ostojaatanasijevic/noise_gate/README.md

# TPI pedals - BMF

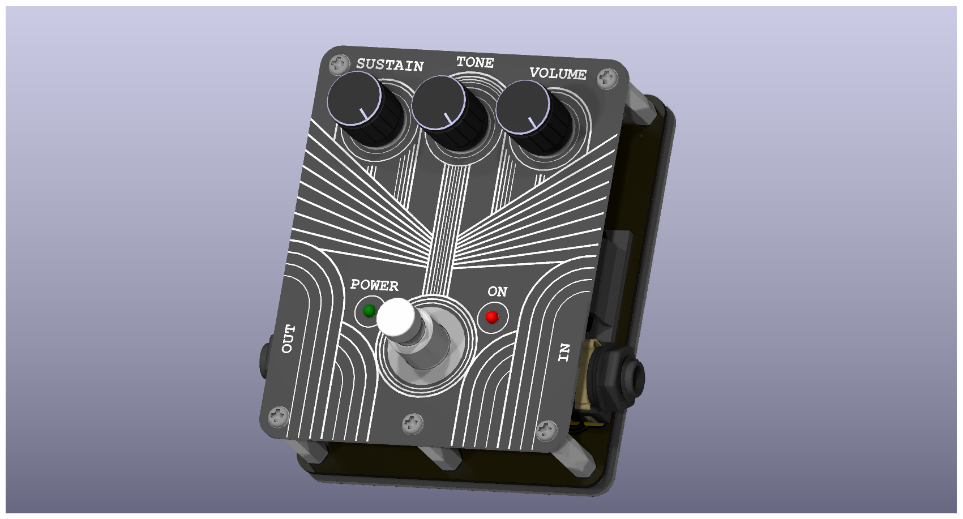
[picture p1: noise_gate/big_muff_pi_side.png]
side_view

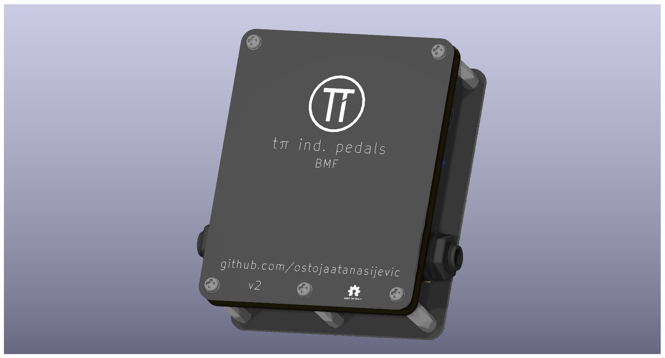
[picture p2: noise_gate/big_muff_pi_bottom.png]
top_view


## Schematic
schematic
