ostojaatanasijevic/noise_gate/noise_gate/big_muff_pi_top.png

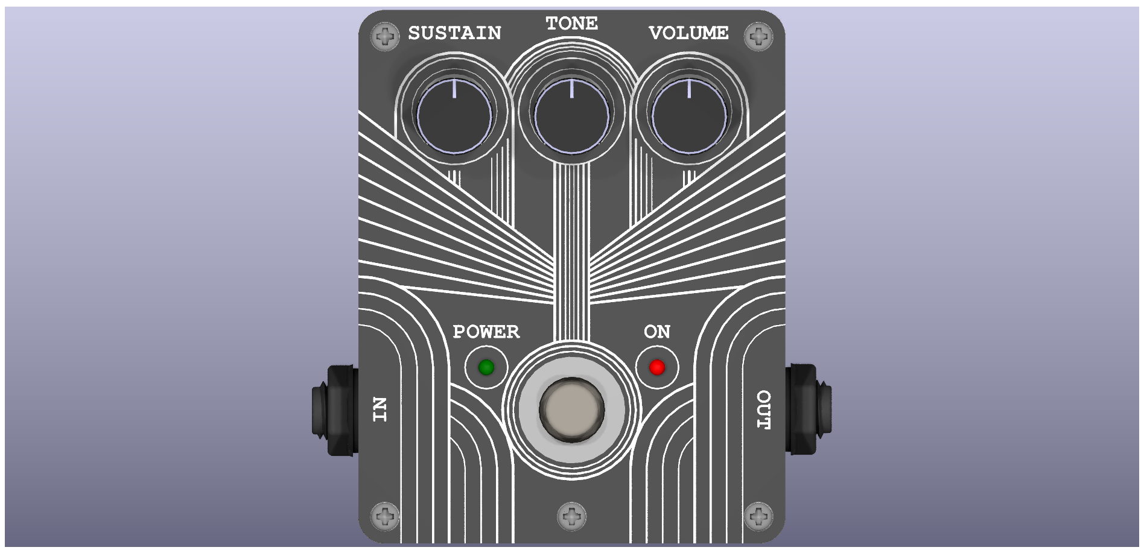
noise_gate/big_muff_pi_top.png
