ostojaatanasijevic/noise_gate/bottom_plate.step

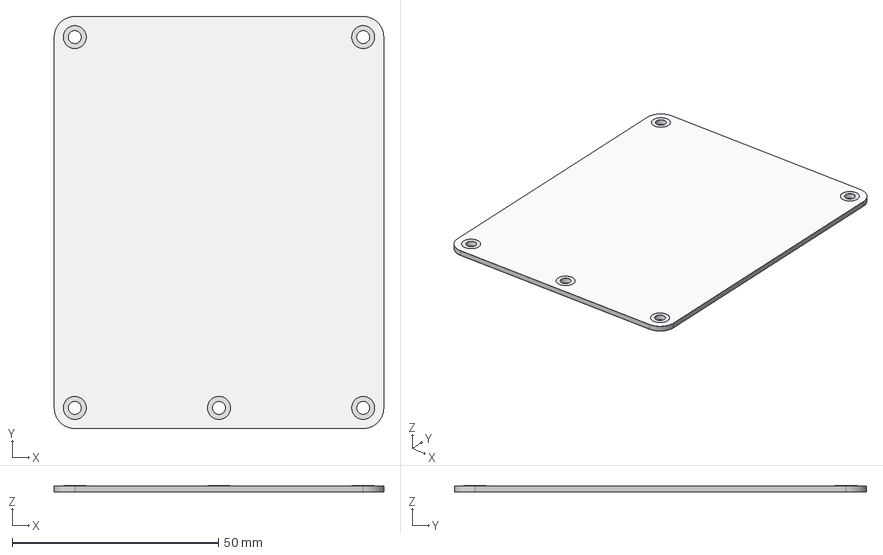
[picture p4: CAD file, 2025-06-01]
bottom_plate.step
80.0 x 100.0 x 1.64 mm
noise_gate_bottom_plate_pad
noise_gate_bottom_plate_silkscreen
noise_gate_bottom_plate_soldermask
noise_gate_bottom_plate_PCB
