ostojaatanasijevic/noise_gate/noise_gate_bottom_plate/3-d-nmj6hhd2.stp

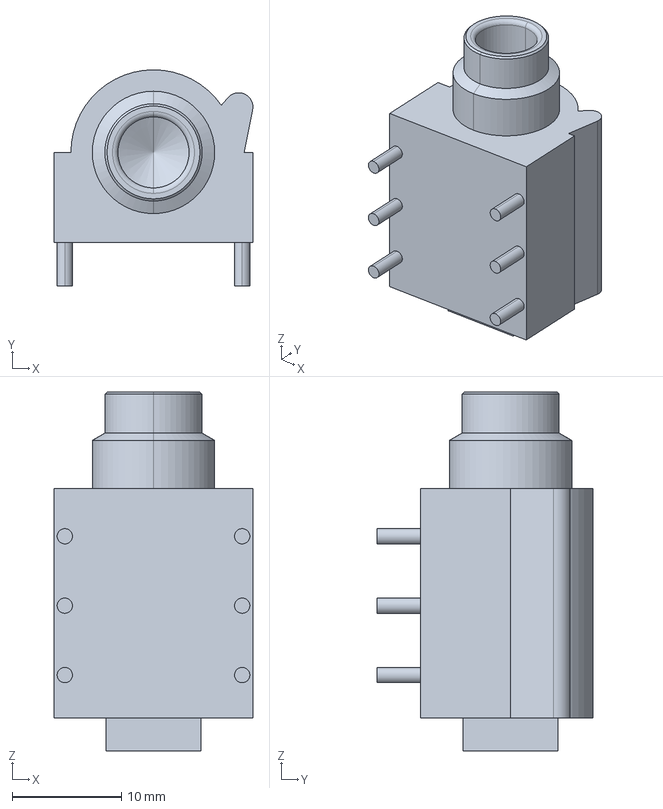
[picture p5: CAD file, 2025-05-28]
noise_gate_bottom_plate/3-d-nmj6hhd2.stp
18.2 x 19.8 x 32.9 mm
