ostojaatanasijevic/noise_gate/noise_gate_bottom_plate/NMJ6HFD2-AU--3DModel-STEP-418109.STEP

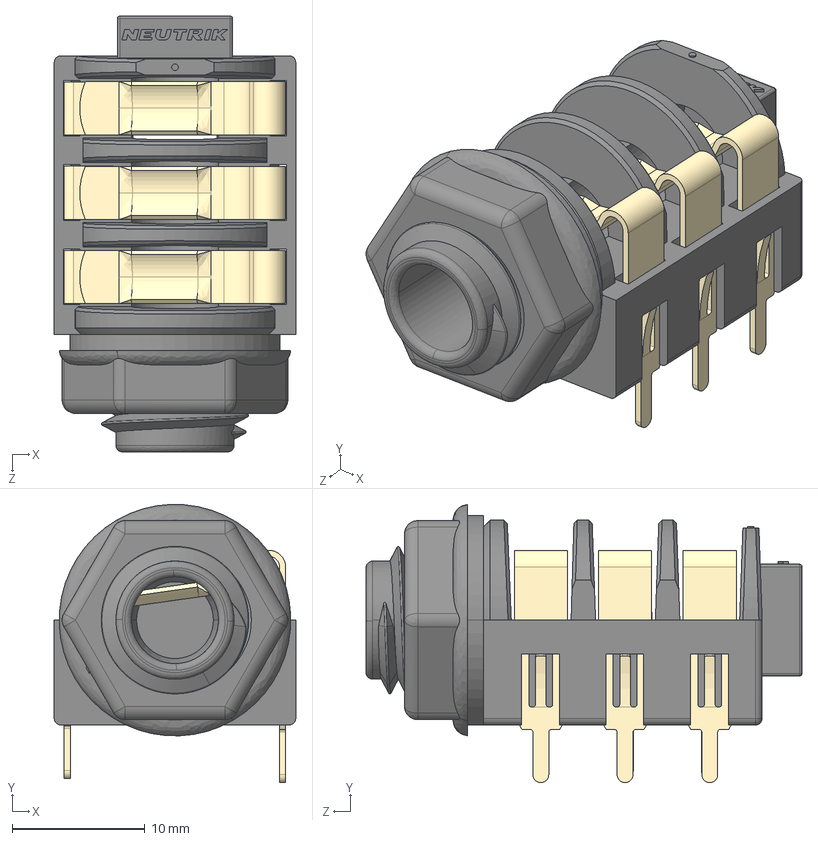
[picture p6: CAD file, 2025-05-28]
noise_gate_bottom_plate/NMJ6HFD2-AU--3DModel-STEP-418109.STEP
18.2 x 21.0 x 32.9 mm
