ostojaatanasijevic/noise_gate/noise_gate_front_plate/switch.STEP

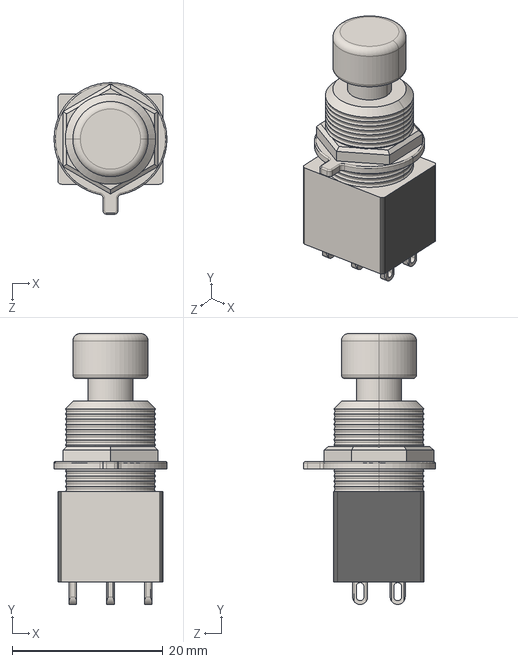
[picture p7: CAD file, 2025-05-28]
noise_gate_front_plate/switch.STEP
15.0 x 36.0 x 17.5 mm
