ostojaatanasijevic/noise_gate/noise_gate_bottom_plate/noise_gate_bottom_plate.step

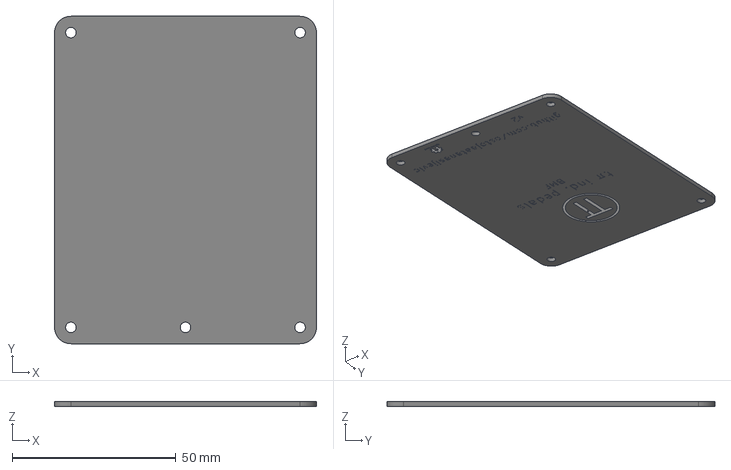
[picture p8: CAD file, 2025-05-28]
noise_gate_bottom_plate/noise_gate_bottom_plate.step
80.0 x 100.0 x 1.58 mm
big_muff_pi_bottom_plate_silkscreen
big_muff_pi_bottom_plate_PCB
