ostojaatanasijevic/noise_gate/noise_gate_front_plate/9V-battery.stp

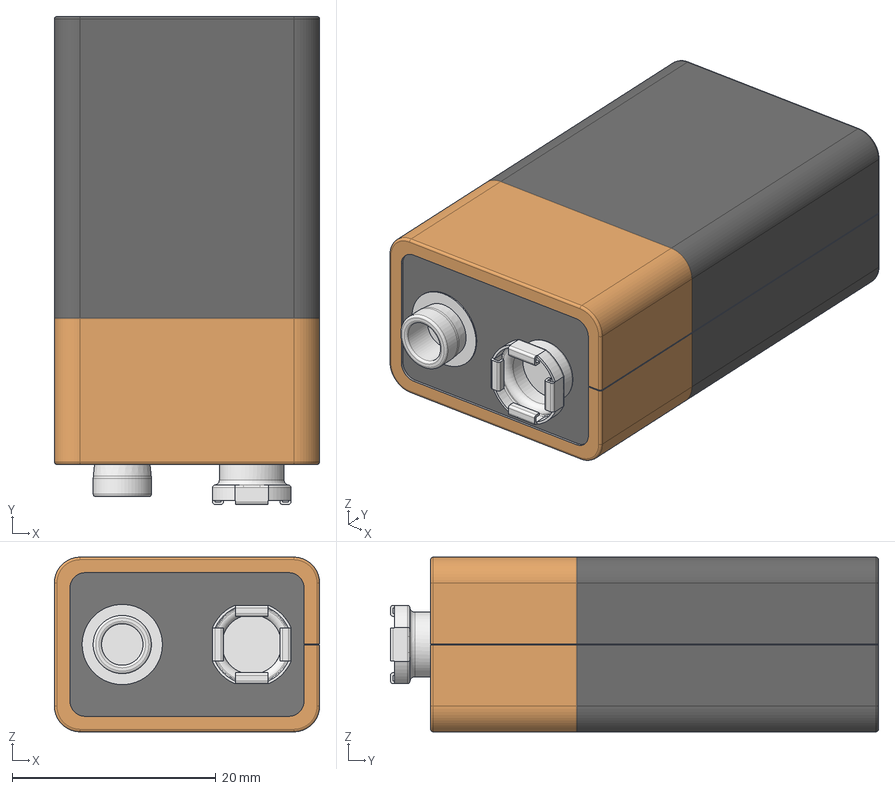
[picture p9: CAD file, 2025-05-28]
noise_gate_front_plate/9V-battery.stp
26.0 x 47.9 x 17.1 mm
