ostojaatanasijevic/noise_gate/noise_gate/input_bjt_stage.asc

C1: cap; 1µ
C2: cap; 470p
Q1: npn; 2N5551
R1: res; 100
R2: res; 47k
R3: res; 4.7k
R4: res; 470k
R5: res; 10k
V1: voltage; SINE(0 20m 1k)
V2: voltage; 9
Named nets: 0
.tran 100m
