ostojaatanasijevic/noise_gate/noise_gate/simulations/Draft1.asc

C1: cap; 1.2µ
C2: cap; 1.2µ
C3: cap; 1.2µ
C4: cap; 1.2µ
L1: ind; 350µ
L2: ind; 350µ
L3: ind; 100µ
L4: ind; 5µ
R1: res; 50
R2: res; 50
V1: voltage; PULSE(-1 1 0 {rise_time} {rise_time} {d / f - rise_time} {1 / f})
V2: voltage; PULSE(-1 1 0 {rise_time} {rise_time} {d / f - rise_time} {1 / f})
V3: voltage; PULSE(-1 1 0 {rise_time} {rise_time} {d / f - rise_time} {1 / f})
Named nets: 0
.param rise_time = 1n
.param d = 0.5
.param f = 500k
.tran 0 10m 7m 0.1
