ostojaatanasijevic/noise_gate/noise_gate/noise_gate.kicad_pcb

## KiCad design noise_gate/noise_gate.kicad_pcb (2025-06-01)

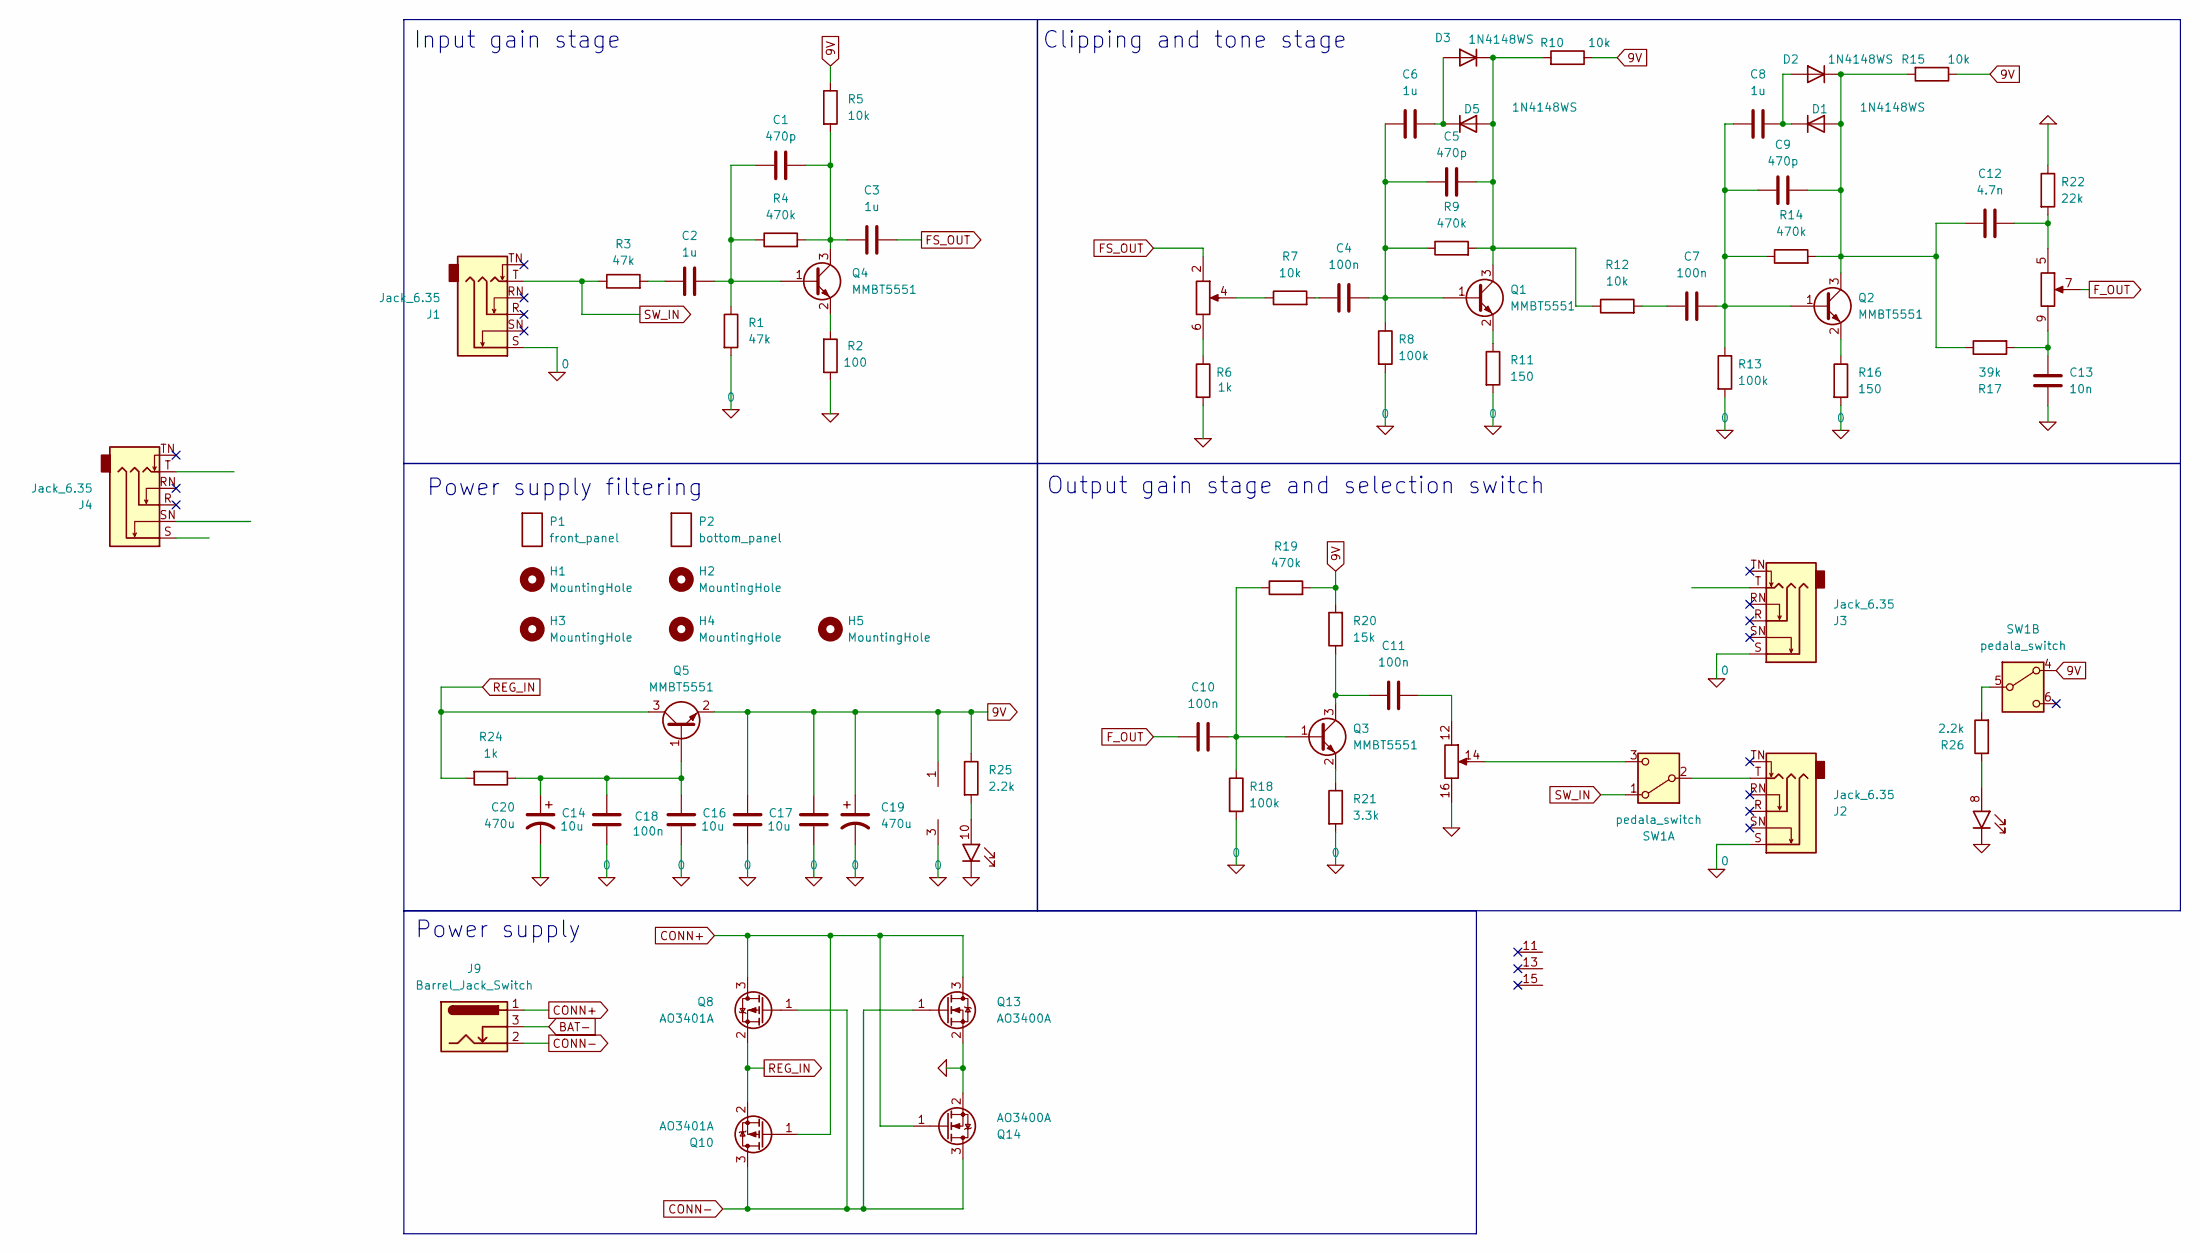
[picture p12: schematic noise_gate.kicad_sch, Noise gate]

Parts:
C1, C5, C9: 470p; C_0603_1608Metric_Pad1.08x0.95mm_HandSolder; LCSC C1620
C2, C3, C6, C8: 1u; C_0603_1608Metric_Pad1.08x0.95mm_HandSolder; LCSC C15849
C4, C7, C10, C11, C18: 100n; C_0603_1608Metric_Pad1.08x0.95mm_HandSolder; LCSC C14663
C12: 4.7n; C_0603_1608Metric_Pad1.08x0.95mm_HandSolder; LCSC C53987
C13: 10n; C_0603_1608Metric_Pad1.08x0.95mm_HandSolder; LCSC C57112
C14, C16, C17: 10u; C_0603_1608Metric_Pad1.08x0.95mm_HandSolder; LCSC C96446
C19, C20: 470u; CP_Radial_D8.0mm_P3.50mm
D1, D2, D3, D5: 1N4148WS; D_SOD-323; LCSC C2128
H1, H2, H3, H4, H5: MountingHole; M3_hole_with_spacer
J1, J2, J3, J4: Jack_6.35; Jack_6.35mm
J6: top_panel_connector; IDC-Header_2x08_P2.54mm_Vertical
J9: Barrel_Jack_Switch; BarrelJack
P1: front_panel; front_plate
P2: bottom_panel; bottom_plate
Q1, Q2, Q3, Q4, Q5: MMBT5551; SOT-23; LCSC C2145
Q8, Q10: AO3401A; SOT-23; LCSC C15127
Q13, Q14: AO3400A; SOT-23; LCSC C20917
R1, R3: 47k; R_0603_1608Metric_Pad0.98x0.95mm_HandSolder; LCSC C25819
R2: 100; R_0603_1608Metric_Pad0.98x0.95mm_HandSolder; LCSC C22775
R4, R9, R14, R19: 470k; R_0603_1608Metric_Pad0.98x0.95mm_HandSolder; LCSC C23178
R5, R7, R10, R12, R15: 10k; R_0603_1608Metric_Pad0.98x0.95mm_HandSolder; LCSC C25804
R6, R24: 1k; R_0603_1608Metric_Pad0.98x0.95mm_HandSolder; LCSC C21190
R8, R13, R18: 100k; R_0603_1608Metric_Pad0.98x0.95mm_HandSolder; LCSC C25803
R11, R16: 150; R_0603_1608Metric_Pad0.98x0.95mm_HandSolder; LCSC C22808
R17: 39k; R_0603_1608Metric_Pad0.98x0.95mm_HandSolder; LCSC C23153
R20: 15k; R_0603_1608Metric_Pad0.98x0.95mm_HandSolder; LCSC C22809
R21: 3.3k; R_0603_1608Metric_Pad0.98x0.95mm_HandSolder; LCSC C22978
R22: 22k; R_0603_1608Metric_Pad0.98x0.95mm_HandSolder; LCSC C31850
R25, R26: 2.2k; R_0603_1608Metric_Pad0.98x0.95mm_HandSolder; LCSC C4190
SW1: pedala_switch; foot_switch_tht_no_pad

Connections:
0: C13.1, C14.2, C16.2, C17.2, C18.1, C19.2, C20.2, J1.S, J2.S, J3.S, J6.3 (GND), J6.16, Q13.2 (S), Q14.2 (S), R1.2, R2.1, R6.2, R8.2, R11.2, R13.2, R16.2, R18.2, R21.2, R22.1
9V: C16.1, C17.1, C19.1, J6.1 (VCC), Q5.2 (E), R5.1, R10.1, R15.1, R19.2, R20.2, R25.1, SW1.4 (A)
BAT-: J9.3
CONN+: J9.1, Q8.3 (D), Q10.1 (G), Q13.3 (D), Q14.1 (G)
CONN-: J9.2, Q8.1 (G), Q10.3 (D), Q13.1 (G), Q14.3 (D)
FS_OUT: C3.2, J6.2
F_OUT: C10.1, J6.7
unnamed: C2.1, R3.2
unnamed: C4.1, R7.2
unnamed: C7.1, R12.2
unnamed: C9.2, C12.1, D1.2 (A), D2.1 (K), Q2.3 (C), R14.2, R15.2, R17.1
unnamed: C8.2, D1.1 (K), D2.2 (A)
unnamed: C6.2, D3.2 (A), D5.1 (K)
unnamed: C5.2, D3.1 (K), D5.2 (A), Q1.3 (C), R9.2, R10.2, R12.1
unnamed: J6.4, R7.1
unnamed: J6.6, R6.1
unnamed: C12.2, J6.5, R22.2
unnamed: C13.2, J6.9, R17.2
unnamed: C11.2, J6.12
unnamed: J6.14, SW1.3 (C)
unnamed: J6.8, R26.1
unnamed: J6.10, R25.2
unnamed: C4.2, C5.1, C6.1, Q1.1 (B), R8.1, R9.1
unnamed: Q1.2 (E), R11.1
unnamed: C7.2, C8.1, C9.1, Q2.1 (B), R13.1, R14.1
unnamed: Q2.2 (E), R16.1
unnamed: C10.2, Q3.1 (B), R18.1, R19.1
unnamed: C11.1, Q3.3 (C), R20.1
unnamed: Q3.2 (E), R21.1
unnamed: C1.1, C2.2, Q4.1 (B), R1.1, R4.1
unnamed: C1.2, C3.1, Q4.3 (C), R4.2, R5.2
unnamed: Q4.2 (E), R2.2
unnamed: C14.1, C18.2, C20.1, Q5.1 (B), R24.1
unnamed: J2.T, SW1.2 (B)
unnamed: R26.2, SW1.5 (B)
REG_IN: Q5.3 (C), Q8.2 (S), Q10.2 (S), R24.2
SW_IN: J1.T, R3.1, SW1.1 (A)

Notes on the sheet:
Power supply filtering
Input gain stage
Output gain stage and selection switch
Clipping and tone stage
Power supply

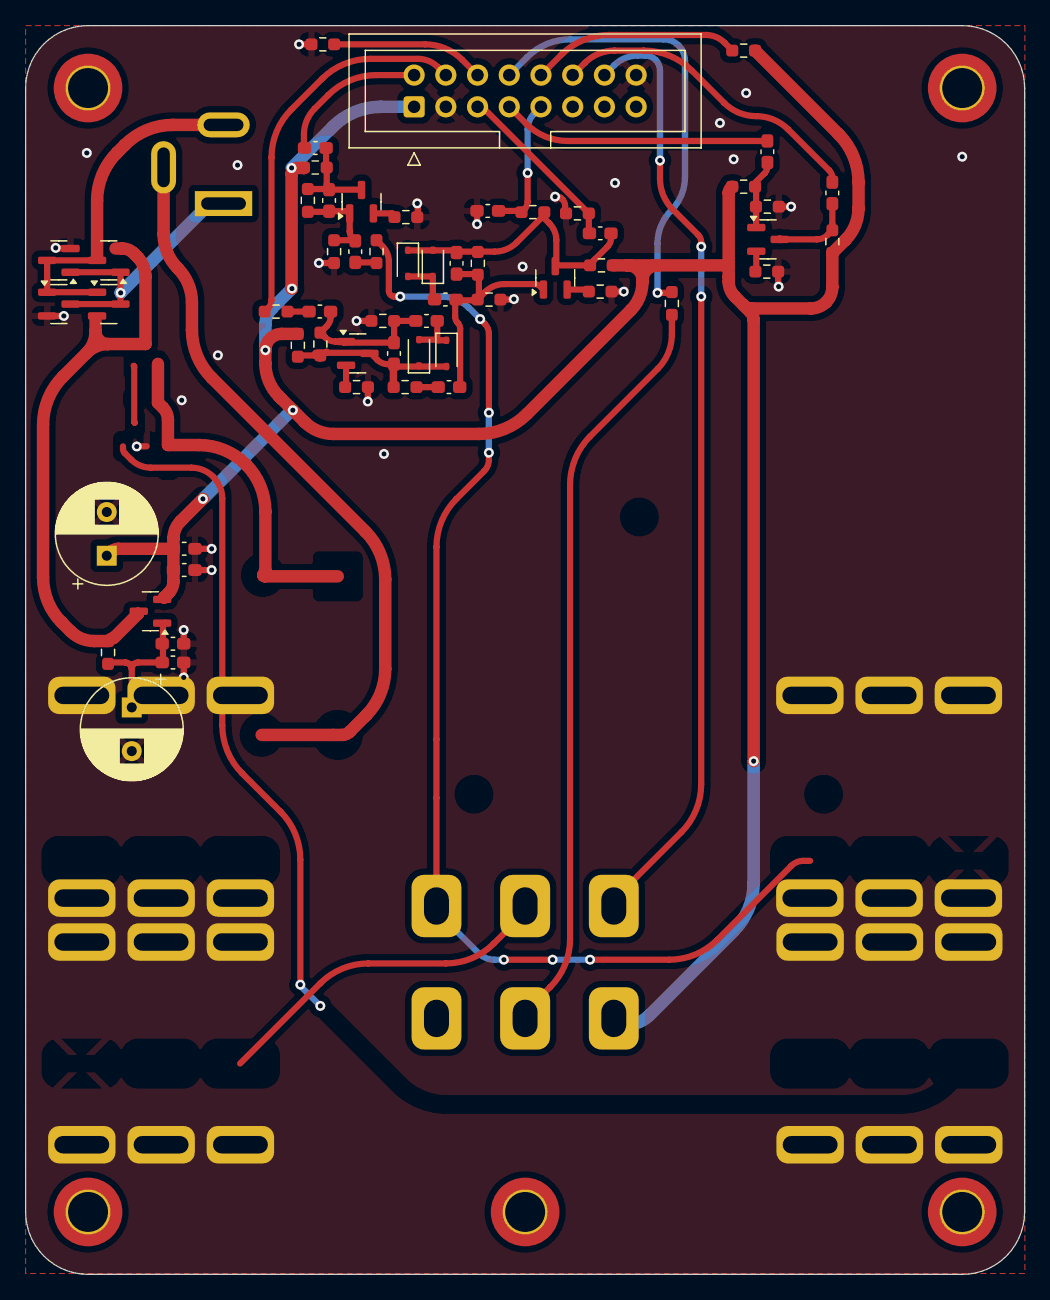
[picture p13: board noise_gate.kicad_pcb from above]

Board: 2 copper layers, 80.0 x 100.0 mm, 71 parts (0 on the bottom side), 36 nets.
