ostojaatanasijevic/noise_gate/(commit log)

2025-05-28 Cloned the BMF, noise gate init.
    [3-d-nmj6hhd2.stp, 9V-battery.stp, NMJ6HFD2-AU--3DModel-STEP-418109.STEP, bom.csv, bottom_plate.step, designators.csv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]
2025-06-01 White pcbs.
    [bottom_plate.step, noise_gate.kicad_pcb, noise_gate.kicad_sch, noise_gate_bottom_plate.kicad_pcb, noise_gate_front_plate.kicad_pcb]
2025-06-01 3d bodies.
    [bottom_plate.step]
